mwalecki/ptbldc/README.md

ptbldc
======

BLDC Motor Controller for a Pan-Tilt Unit

ssh -N -L 4243:127.0.0.1:4242 lwr-sensors
