mwalecki/ptbldc/Src/pid.c

/*This file has been prepared for Doxygen automatic documentation generation.*/
/*! \file *********************************************************************
 *
 * \brief General PID implementation for AVR.
 *
 * Discrete PID controller implementation. Set up by giving P/I/D terms
 * to Init_PID(), and uses a struct PID_DATA to store internal values.
 *
 * - File:               pid.c
 * - Compiler:           IAR EWAAVR 4.11A
 * - Supported devices:  All AVR devices can be used.
 * - AppNote:            AVR221 - Discrete PID controller
 *
 * \author               Atmel Corporation: http://www.atmel.com \n
 *                       Support email: avr@atmel.com
 *
 * $Name$
 * $Revision: 456 $
 * $RCSfile$
 * $Date: 2006-02-16 12:46:13 +0100 (to, 16 feb 2006) $
 *****************************************************************************/

#include "pid.h"
#include "stdint.h"

/*! \brief Set default PID controller parameters.
 *
 *  Initialise the variables used by the PID algorithm.
 *
 *  \param p_factor  Proportional term.
 *  \param i_factor  Integral term.
 *  \param d_factor  Derivate term.
 *  \param pid  Struct with PID status.
 */
void PID_LoadDefaults(PID_St *pid)
// Set up PID controller parameters
{
  // Start values for PID controller
  pid->sumError = 0;
  pid->lastProcessValue = 0;
  // Tuning constants for PID loop
  pid->P_Factor = PID_DEFAULT_P;
  pid->I_Factor = PID_DEFAULT_I;
  pid->D_Factor = PID_DEFAULT_D;
  // Limits to avoid overflow
  pid->maxError = MAX_INT / (pid->P_Factor + 1);
  pid->maxSumError = MAX_I_TERM / (pid->I_Factor + 1);
}

/*! \brief Initialisation of PID controller parameters.
 *
 *  Initialise the variables used by the PID algorithm.
 *
 *  \param pid  Struct with PID status.
 */
void PID_Init(PID_St *pid)
// Set up PID controller parameters
{
  // Start values for PID controller
  pid->sumError = 0;
  pid->lastProcessValue = 0;
  // Tuning constants for PID loop
//  pid->P_Factor = p_factor;
//  pid->I_Factor = i_factor;
//  pid->D_Factor = d_factor;
  // Limits to avoid overflow
  pid->maxError = MAX_INT / (pid->P_Factor + 1);
  pid->maxSumError = MAX_I_TERM / (pid->I_Factor + 1);
}


/*! \brief PID control algorithm.
 *
 *  Calculates output from setpoint, process value and PID status.
 *
 *  \param pid_st  PID status struct.
 */
int32_t PID_Controller(PID_St *pid_st)
{
  int32_t err, p_term, d_term;
  int64_t i_term, ret, temp;

  err = pid_st->referenceValue - pid_st->measurementValue;

  // Calculate Pterm and limit error overflow
  if (err > pid_st->maxError){
    p_term = MAX_INT;
  }
  else if (err < -pid_st->maxError){
    p_term = -MAX_INT;
  }
  else{
    p_term = pid_st->P_Factor * err;
  }

  // Calculate Iterm and limit integral runaway
  temp = pid_st->sumError + err;
  if(temp > pid_st->maxSumError){
    i_term = MAX_I_TERM;
    pid_st->sumError = pid_st->maxSumError;
  }
  else if(temp < -pid_st->maxSumError){
    i_term = -MAX_I_TERM;
    pid_st->sumError = -pid_st->maxSumError;
  }
  else{
    pid_st->sumError = temp;
    i_term = pid_st->I_Factor * pid_st->sumError;
  }

  // Calculate Dterm
  d_term = pid_st->D_Factor * (pid_st->lastProcessValue - pid_st->measurementValue);

  pid_st->lastProcessValue = pid_st->measurementValue;

  ret = (p_term + i_term + d_term) / SCALING_FACTOR;
  if(ret > MAX_INT){
    ret = MAX_INT;
  }
  else if(ret < -MAX_INT){
    ret = -MAX_INT;
  }

  return((int32_t)ret);
}

/*! \brief Resets the integrator.
 *
 *  Calling this function will reset the integrator in the PID regulator.
 */
void pid_Reset_Integrator(PID_St *pid_st)
{
  pid_st->sumError = 0;
}
