mwalecki/ptbldc/Src/adc.c

#include "adc.h"
#include "nf/nfv2.h"
#include "motor.h"

extern ADC_St				ADC;
extern NF_STRUCT_ComBuf 	NFComBuf;
extern MOTOR_St				Motor;

void ADCwithDMA_Config(void){
	ADC_InitTypeDef ADC_InitStructure;
	DMA_InitTypeDef DMA_InitStructure;
	GPIO_InitTypeDef GPIO_InitStructure;

	// AFIO Clock Enable
	RCC_APB2PeriphClockCmd(RCC_APB2Periph_AFIO, ENABLE);
	// GPIO clocks enable
	RCC_APB2PeriphClockCmd(RCC_APB2Periph_GPIOA, ENABLE);

	/*	PORT A Floating Inputs:				*\
		PA.4	Current1
		PA.5	Current2					*/
	GPIO_InitStructure.GPIO_Pin = GPIO_Pin_4 | GPIO_Pin_5;
	GPIO_InitStructure.GPIO_Speed = GPIO_Speed_50MHz;
	GPIO_InitStructure.GPIO_Mode = GPIO_Mode_AIN;
	GPIO_Init(GPIOA, &GPIO_InitStructure);

	
	//DMA 
    RCC_AHBPeriphClockCmd(RCC_AHBPeriph_DMA1, ENABLE); 
	
	/* PCLK2 is the APB2 clock */
	/* ADCCLK = PCLK2/6 = 72/6 = 12MHz*/
	RCC_ADCCLKConfig(RCC_PCLK2_Div6);
	
	/* Enable ADC1 clock so that we can talk to it */
	RCC_APB2PeriphClockCmd(RCC_APB2Periph_ADC1, ENABLE);
	/* Put everything back to power-on defaults */
	ADC_DeInit(ADC1);
	
	/* DMA1 channel1 configuration ----------------------------------------------*/
	DMA_DeInit(DMA1_Channel1);
	DMA_InitStructure.DMA_PeripheralBaseAddr = ADC1_DR_Address;
	DMA_InitStructure.DMA_MemoryBaseAddr = (u32)&(ADC.raw[0]);
	// Data direction: Peripheral is source
	DMA_InitStructure.DMA_DIR = DMA_DIR_PeripheralSRC;
	// Data Buffer Size
//	DMA_InitStructure.DMA_BufferSize = 9;
	DMA_InitStructure.DMA_BufferSize = 8;
	// Do not increment Peripheral Address Register
	DMA_InitStructure.DMA_PeripheralInc = DMA_PeripheralInc_Disable;
	// Do increment destination memory pointer
	DMA_InitStructure.DMA_MemoryInc = DMA_MemoryInc_Enable;
	DMA_InitStructure.DMA_PeripheralDataSize = DMA_PeripheralDataSize_HalfWord;
	DMA_InitStructure.DMA_MemoryDataSize = DMA_MemoryDataSize_HalfWord;
	// Transport data repeatedly
	DMA_InitStructure.DMA_Mode = DMA_Mode_Circular;
	DMA_InitStructure.DMA_Priority = DMA_Priority_High;
	// Memory to Memory Mode Disabled
	DMA_InitStructure.DMA_M2M = DMA_M2M_Disable;
	// Enable DMA Channel
	DMA_Init(DMA1_Channel1, &DMA_InitStructure);      
	#ifdef ADC_DMA_TransferCompleteInterrupt
		/* Enable DMA1 Channel Transfer Complete interrupt */
		DMA_ITConfig(DMA1_Channel1, DMA_IT_TC, ENABLE);
	#endif //ADC_DMA_TransferCompleteInterrupt
	/* Enable DMA1 channel1 */
	DMA_Cmd(DMA1_Channel1, ENABLE);
	 
	/* ADC1 configuration ------------------------------------------------------*/
	ADC_InitStructure.ADC_Mode = ADC_Mode_Independent;
	ADC_InitStructure.ADC_ScanConvMode = ENABLE;
	ADC_InitStructure.ADC_ContinuousConvMode = ENABLE;
	ADC_InitStructure.ADC_ExternalTrigConv = ADC_ExternalTrigConv_None;
	ADC_InitStructure.ADC_DataAlign = ADC_DataAlign_Right;
	// number of ADC channels that will be converted using the sequencer
//	ADC_InitStructure.ADC_NbrOfChannel = 9;
	ADC_InitStructure.ADC_NbrOfChannel = 8;
	ADC_Init(ADC1, &ADC_InitStructure);
	/* ADC1 regular channels configuration */ 
	ADC_RegularChannelConfig(ADC1, ADC_Channel_10, 1, ADC_SampleTime_71Cycles5); //AIN0
	ADC_RegularChannelConfig(ADC1, ADC_Channel_11, 2, ADC_SampleTime_71Cycles5); //AIN1
	ADC_RegularChannelConfig(ADC1, ADC_Channel_5, 3, ADC_SampleTime_71Cycles5); //THERM0
	ADC_RegularChannelConfig(ADC1, ADC_Channel_6, 4, ADC_SampleTime_71Cycles5); //THERM1
	ADC_RegularChannelConfig(ADC1, ADC_Channel_14, 5, ADC_SampleTime_71Cycles5); //PVCC
	ADC_RegularChannelConfig(ADC1, ADC_Channel_15, 6, ADC_SampleTime_71Cycles5); //24V
	ADC_RegularChannelConfig(ADC1, ADC_Channel_8, 7, ADC_SampleTime_71Cycles5); //12V
	ADC_RegularChannelConfig(ADC1, ADC_Channel_9, 8, ADC_SampleTime_71Cycles5); //5V
//	ADC_RegularChannelConfig(ADC1, ADC_Channel_4, 9, ADC_SampleTime_71Cycles5); //MOTORCURRENT
	/* Enable ADC1 DMA */
	ADC_DMACmd(ADC1, ENABLE);
	

	// INJECTED
	/* Set injected sequencer length */
	ADC_InjectedSequencerLengthConfig(ADC1, 2);
	/* ADC1 injected channel Configuration */
	ADC_InjectedChannelConfig(ADC1, ADC_Channel_4, 1, ADC_SampleTime_71Cycles5);
	ADC_InjectedChannelConfig(ADC1, ADC_Channel_5, 2, ADC_SampleTime_71Cycles5);
	/* ADC1 injected external trigger configuration */
	ADC_ExternalTrigInjectedConvConfig(ADC1, ADC_ExternalTrigInjecConv_T1_TRGO);

	ADC_ExternalTrigInjectedConvCmd(ADC1, ENABLE);

	/* Enable JEOC interrupt */
	ADC_ITConfig(ADC1, ADC_IT_JEOC, ENABLE);

	/* Enable ADC1 */
	ADC_Cmd(ADC1, ENABLE);
	
	/* Enable ADC1 reset calibaration register */   
	ADC_ResetCalibration(ADC1);
	/* Check the end of ADC1 reset calibration register */
	while(ADC_GetResetCalibrationStatus(ADC1));
	
	/* Start ADC1 calibaration */
	ADC_StartCalibration(ADC1);
	/* Check the end of ADC1 calibration */
	while(ADC_GetCalibrationStatus(ADC1));
	
	/* Start ADC1 Software Conversion */ 
	ADC_SoftwareStartConvCmd(ADC1, ENABLE);

	ADC.uVoltsPerUnit = 7975;
	ADC.unitsOffset = 0;
	ADC.logicZeroMax_mV = 6000;
	ADC.logicOneMin_mV = 18000;

	ADC.currentMeasure_uVoltsPerUnit = 1217;
	ADC.currentMeasure_unitsOffset = 12;
	//ADC.currentMeasure_mVOffset = 2500; // User configurable
	ADC.currentMeasure_uAmperesPermV = -9302;
	ADC.currentMeasure_miliampereInsensitivity = 10;
	// 215mV = -2000mA
}

void DMA1_Channel1_IRQHandler(void)
{
	uint8_t i;
	s16 raw;

	DMA_ClearITPendingBit(DMA1_IT_TC1);
	for(i=0; i<ADC_VoltageChannels; i++){
		raw = ADC.raw[i] - ADC.unitsOffset;
		if(raw < 0)
			raw = 0;
		ADC.milivolt[i] = raw * ADC.uVoltsPerUnit / 1000;
		NFComBuf.ReadAnalogInputs.data[i] = ADC.milivolt[i];

		if(ADC.milivolt[i] <= ADC.logicZeroMax_mV)
			ADC.digital[i/8] &= ~(1 << (i%8));
		else if(ADC.milivolt[i] >= ADC.logicOneMin_mV)
			ADC.digital[i/8] |= (1 << (i%8));
	}
//	NFComBuf.ReadDigitalInputs.data[0] = ADC.digital[0];
}

void ADC1_2_IRQHandler(void)
{
	s32 raw;
	s32 pwm;
	/* Set PC.06 pin */
	GPIO_WriteBit(GPIOC, GPIO_Pin_6, Bit_SET);
	/* Get injected channel11 converted value */

	ADC.currentMeasure_raw[0] = ADC_GetInjectedConversionValue(ADC1, ADC_InjectedChannel_1);
	raw = ADC.currentMeasure_raw[0] - ADC.currentMeasure_unitsOffset;
	if(raw < 0)
		raw = 0;
	ADC.currentMeasure_milivolt[0] = raw * ADC.currentMeasure_uVoltsPerUnit / 1000;
	raw = (ADC.currentMeasure_milivolt[0] - ADC.currentMeasure_mVOffset) * ADC.currentMeasure_uAmperesPermV / 1000;

	NFComBuf.ReadDeviceVitals.data[5] = raw;

	if((raw > -ADC.currentMeasure_miliampereInsensitivity) && (raw < ADC.currentMeasure_miliampereInsensitivity))
		raw = 0;

	ADC.currentMeasure_miliampere[0] = raw;

	NFComBuf.ReadDeviceVitals.data[3] = ADC.currentMeasure_raw[0];
	NFComBuf.ReadDeviceVitals.data[4] = ADC.currentMeasure_milivolt[0];
	NFComBuf.ReadDeviceVitals.data[6] = ADC.currentMeasure_miliampere[0];
	NFComBuf.ReadDeviceVitals.data[7] = -ADC.currentMeasure_miliampere[0];
	NFComBuf.ReadDrivesCurrent.data[0] = ADC.currentMeasure_miliampere[0];
	/* Clear ADC1 JEOC pending interrupt bit */
	ADC_ClearITPendingBit(ADC1, ADC_IT_JEOC);
	/* Reset PC.06 pin */
GPIO_WriteBit(GPIOC, GPIO_Pin_6, Bit_RESET);
}
