mwalecki/ptbldc/Src/interrupts.c

#include "interrupts.h"
#include "adc.h"

void NVIC_Configuration(void)
{						   
NVIC_InitTypeDef NVIC_InitStructure;

#ifdef  VECT_TAB_RAM  
  /* Set the Vector Table base location at 0x20000000 */ 
  NVIC_SetVectorTable(NVIC_VectTab_RAM, 0x0); 
#else  /* VECT_TAB_FLASH  */
  /* Set the Vector Table base location at 0x08000000 */ 
  NVIC_SetVectorTable(NVIC_VectTab_FLASH, 0x0);   
#endif
	
	// Configure the NVIC Preemption Priority Bits
	NVIC_PriorityGroupConfig(NVIC_PriorityGroup_1);
	
	// Enable the USART1 Interrupt
	NVIC_InitStructure.NVIC_IRQChannel = USART1_IRQn;
	NVIC_InitStructure.NVIC_IRQChannelPreemptionPriority = 1;
	NVIC_InitStructure.NVIC_IRQChannelSubPriority = 1;
	NVIC_InitStructure.NVIC_IRQChannelCmd = ENABLE;
	NVIC_Init(&NVIC_InitStructure);

	#ifdef ADC_DMA_TransferCompleteInterrupt
	/* Enable DMA1 channel1 IRQ Channel */
	NVIC_InitStructure.NVIC_IRQChannel = DMA1_Channel1_IRQn;
	NVIC_InitStructure.NVIC_IRQChannelPreemptionPriority = 1;
	NVIC_InitStructure.NVIC_IRQChannelSubPriority = 4;
	NVIC_InitStructure.NVIC_IRQChannelCmd = ENABLE;
	NVIC_Init(&NVIC_InitStructure);
	#endif //ADC_DMA_TransferCompleteInterrupt

	/* Enable EXTI0 Interrupt - Encoder Index Signal */
	NVIC_InitStructure.NVIC_IRQChannel = EXTI0_IRQn;
	NVIC_InitStructure.NVIC_IRQChannelPreemptionPriority = 1;
	NVIC_InitStructure.NVIC_IRQChannelSubPriority = 0;
	NVIC_InitStructure.NVIC_IRQChannelCmd = ENABLE;
	NVIC_Init(&NVIC_InitStructure);

	// we use preemption interrupts here,  BLDC Bridge switching and
	// Hall has highest priority
	NVIC_InitStructure.NVIC_IRQChannel = TIM4_IRQn;
	NVIC_InitStructure.NVIC_IRQChannelPreemptionPriority = 0;
	NVIC_InitStructure.NVIC_IRQChannelSubPriority = 0;
	NVIC_InitStructure.NVIC_IRQChannelCmd = ENABLE;
	NVIC_Init(&NVIC_InitStructure);

	// Enable USB Interrupt
	//NVIC_InitStructure.NVIC_IRQChannel = USB_LP_CAN1_RX0_IRQn;
	//NVIC_InitStructure.NVIC_IRQChannelPreemptionPriority = 1;
	//NVIC_InitStructure.NVIC_IRQChannelSubPriority = 0;
	//NVIC_InitStructure.NVIC_IRQChannelCmd = ENABLE;
	//NVIC_Init(&NVIC_InitStructure);

	// Enable CAN RX Interrupt
	NVIC_InitStructure.NVIC_IRQChannel = USB_LP_CAN1_RX0_IRQn;
	NVIC_InitStructure.NVIC_IRQChannelPreemptionPriority = 1;
	NVIC_InitStructure.NVIC_IRQChannelSubPriority = 1;
	NVIC_InitStructure.NVIC_IRQChannelCmd = ENABLE;
	NVIC_Init(&NVIC_InitStructure);

	// Configure SysTick Interrupt
	NVIC_InitStructure.NVIC_IRQChannel = SysTick_IRQn;
	NVIC_InitStructure.NVIC_IRQChannelPreemptionPriority = 0;
	NVIC_InitStructure.NVIC_IRQChannelSubPriority = 1;
	NVIC_InitStructure.NVIC_IRQChannelCmd = ENABLE;
	NVIC_Init(&NVIC_InitStructure);

	// Configure TIM1_CC Interrupt
	NVIC_InitStructure.NVIC_IRQChannel = TIM1_CC_IRQn;
	NVIC_InitStructure.NVIC_IRQChannelPreemptionPriority = 0;
	NVIC_InitStructure.NVIC_IRQChannelSubPriority = 0;
	NVIC_InitStructure.NVIC_IRQChannelCmd = ENABLE;
	NVIC_Init(&NVIC_InitStructure);

	// ADC End Of Injected Conversion
	NVIC_InitStructure.NVIC_IRQChannel = ADC1_2_IRQn;
	NVIC_InitStructure.NVIC_IRQChannelPreemptionPriority = 0;
	NVIC_InitStructure.NVIC_IRQChannelSubPriority = 0;
	NVIC_InitStructure.NVIC_IRQChannelCmd = ENABLE;
	NVIC_Init(&NVIC_InitStructure);
}
