mwalecki/ptbldc/Src/hall.h

#ifndef _HALL_H_
#define _HALL_H_
						
#include "common.h"		
#include "motor.h"


//##                                      #### ######## ################ PROTOTYPES:

void	HALL_Config(void);
uint8_t	HALL_Pattern(void);


#endif	// ifndef _HALL_H_
