mwalecki/ptbldc/Src/interrupts.h

#ifndef _INTERRUPTS_H_
#define _INTERRUPTS_H_
						
#include "common.h"


//##                                      #### ######## ################ PROTOTYPES:

void NVIC_Configuration(void);

#endif	// ifndef _INTERRUPTS_H_
