mwalecki/ptbldc/(commit log)

2012-11-06 First commit. LED display almost works ;-)
2012-11-08 LED display works fine.
2012-11-12 fixed some USB communication issues
    [main.c, myscpi.c, usb.c]
2012-11-13 added PCB schematics
2012-11-13 encoder configuration ok, ready for tests
2012-11-13 after encoder merge
2012-11-16 Added Hall and Motor configuration. Motor block commutation in PWM mode seems to work fine.
2012-11-17 ADC with DMA. ADC and position values available through NFv2 protocol.
2012-11-18 position regulator
2012-11-22 position regulator restored
2012-11-23 works on motor.c
2012-11-26 solved motor status bug
    [motor.c]
2012-11-30 usb connected device acts as a master on RS-485 to link to other devices.
2012-12-05 current state on LED display
2013-01-09 Speed is set in motors/100ms. SetSpeed-based trajectory generation in position mode.
2013-03-08 interrupts priorities
2013-03-10 added missing circbuf. Change of Synchro modes numbers in nf.
    [circbuf.c, circbuf.h]
2013-05-17 communication watchdog, interrupts
2013-08-09 cleaning up mess in motor.c
2013-08-12 PID coefficient prescaller 1000. Encoder polarity setting. Sine commutation for forward rotation.
2013-11-02 DC Motor outputs remap, dependent on config
2013-12-13 Position regulator upgrade: Desired speed feed forward to pwm
2014-01-14 Current regulator.
2014-01-15 Current control via CAN. Configurable current sensor output offset.
2014-02-19 Set zero current on switch to current ctrl mode. CAN communication timeout resets control values.
    [CAN_usr.c, adc.c, main.c, motor.c, motor.h, systick.h]
